cardoza5345/New-Member-Rocket-Engine/README.md

# New-Member-Rocket-Engine
Development of an engine prototype to be used in the production of a new member's rocket for incoming Rocket Project SDSU members to get hands-on experience in liquid fuel rocket production and introduce them to the club
