cardoza5345/New-Member-Rocket-Engine/NMR Tank Calcs.xlsx

Sheet: 6061-T6 Tank Specs
Store Bought T6-6061 Alumimum Tube
This Portion calculates the Factor of Saftey for a commercially available Aluminum tube as the basis for the TEZ fuel tanks
Outer Diameter (d_o) [in] | Thickness (t) [in] | Yield Strength (Sigma_y) [psi] | Allowable Stress (S) [psi] (ASME) | Radius (r) [in] | Mean Radius (r_m) [in] | Internal Operating Pressure (P) [psi]
4 | 0.1875 | 40000 | 26666.66667 | 2 | 1.953125 | 360
Hoop Stress (Sigma_h) [psi] | Axial Stress (Tau_a) [psi] | Burst Pressure | Burst Hoop Stress (Sigma_h) [psi] | Burst Axial Stress (Tau_a) [psi] | Desired Bulkhead FOS | Bulkhead stress [psi]
3750 | 1875 | 2500 | 26041.66667 | 13020.83333 | 4 | 10000
At MEOP --> | FOS (ASME) | FOS (ASME) (Corrected) | At burst pressure (2.78x MEOP) --> | FOS (ASME) | FOS (ASME Corrected) | Min. Bulkhead Thickness [in] | Note: Old ASME specifications typically defunct, use Corrected values
 | 7.111111111 | 10.66666667 |  | 1.024 | 1.536 | 0.3091187189
Links
Tube | here (https://www.onlinemetals.com/en/buy/aluminum/8-od-x-0-125-wall-x-7-75-id-aluminum-round-tube-6061-t6-extruded/pid/7083)
Material Sheet: | here (https://asm.matweb.com/search/specificmaterial.asp?bassnum=ma6061t6)
MMPDS Sheet: | here (https://drive.google.com/file/d/10JeMpgRRerTJnKGLHD3Lh879pCKpbLCK/view?usp=sharing)
 |  |  |  | Bore Diameter (d9) [in] |  | 3.762473228

Sheet: O-Ring (2-340) Parameters
 | O-ring OD [in] | O-ring ID (d1) [in] | Backup O-ring Area | O-ring Width [in] | O-ring Area [in^2] | Number of Backup Rings
 | 3.77 | 3.35 | 0.01281 | 0.2098425197 | 0.03458413089 | 0
Calculating parameters --> | Groove Diameter [in] | Chamber Width (to tank wall) [in] | Gland Width (b) [in] | Gland Area [in^2] | Squeeze (%) | Stretch (%) | Gland Fill (%)
 | 3.45 | 0.1570866142 | 0.2834645669 | 0.04452848906 | 25.14071295 | 2.985074627 | 77.6674251
From Paker handbook: | Dash Number | ID (d1) | O-ring Width (d2) | Groove Width (0 BURs) (b1) | Bore Diameter (d4/d9) |  | Groove Diameter (d3)
(metric) --> | 2-340 | 85.09 | 5.33 | 7.2 | 95.61 |  | 87.63
(imperial) --> |  | 3.35 | 0.2098425197 | 0.2834645669 | 3.764173228 |  | 3.45
 | Tolerances: (in) |  | MAX (+) | 0.0098 | 0.0025 | -0.0017 | 0.0000
 |  |  | MIN (-) | 0.0000 | 0.0000 | -0.0033 | -0.0039
 | Tolerances found here (https://theoreticalmachinist.com/IsoMetricTolerance) |  |  | ISO tolerances: | H8 | f7 | h9
 | (direct from handbook) -->
 | Links: | 431 O-rings | McMaster-Carr #9452K418 link (https://www.mcmaster.com/9452K209/?s=340+o+ring)
Spacing Notes | Space between o-rings should be 1-1.5x the diameter of the o-rings and no less than 1 mm
 | Lip width (distance from end of bulkhead to first o-ring) should be equal or greater than the groove width

Sheet: O-Ring (2-236) Parameters
 | O-ring OD [in] | O-ring ID (d1) [in] | Backup O-ring Area | O-ring Width [in] | O-ring Area [in^2] | Number of Backup Rings
 | 3.512 | 3.233858268 | 0.005831 | 0.138976378 | 0.0151695207 | 1
Calculating parameters --> | Groove Diameter [in] | Chamber Width (to tank wall) [in] | Gland Width (b) [in] | Gland Area [in^2] | Squeeze (%) | Stretch (%) | Gland Fill (%)
 | 3.330708661 | 0.1025590551 | 0.2519685039 | 0.02584165168 | 26.20396601 | 2.994886779 | 81.26617043 | <<
From Paker handbook: | Dash Number | ID (d1) | O-ring Width (d2) | Groove Width (0 BURs) (b1) | Bore Diameter (d4/d9) |  | Groove Diameter (d3)
(metric) --> | 2-236 | 82.14 | 3.53 | 6.4 | 89.81 |  | 84.6
(imperial) --> |  | 3.233858268 | 0.138976378 | 0.2519685039 | 3.535826772 |  | 3.330708661
 | Tolerances: (in) |  | MAX (+) | 0.0098 | 0.0025 | -0.0017 | 0.0000
 |  |  | MIN (-) | 0.0000 | 0.0000 | -0.0033 | -0.0039
 | Tolerances found here (https://theoreticalmachinist.com/IsoMetricTolerance) |  |  | ISO tolerances: | H8 | f7 | h9
 | (direct from handbook) -->
 | Links: | 431 O-rings | McMaster-Carr #9452K418 link (https://www.mcmaster.com/9452K165/?s=236+o+ring)
Spacing Notes | Space between o-rings should be 1-1.5x the diameter of the o-rings and no less than 1 mm
 | Lip width (distance from end of bulkhead to first o-ring) should be equal or greater than the groove width

Sheet: Bolt Circle Calculations
 | Bulkhead Mounting Screw Calculations
 | Inner casing diameter [in] | Thickness [in] | Operating pressure [psi] | Number of bolts | Bearing Yield Strength [psi] | Shear Strength [psi] | Ultimate Tensile Strength [psi] | Yield Tensile Strength [psi]
 | 3.625 | 0.1875 | 360 | 8 | 56000 | 30000 | 45000 | 40000
 | Bolt Force | Tear-out FOS | Tear-out Stress [psi] | Distance from end to bolt edge (Emin) [in] | Bolt TPI (UNF)
 | 464.4280233 | 4 | 7500 | 0.1651299639 | 16
 | Bearing FOS | Bearing Stress [psi] | Major bolt diameter [in] | Minor bolt diameter [in] | Tensile stress [psi] | Tensile FOS | Bolt shear stress [psi] | Bolt shear FOS
 | 4 | 14000 | 0.1769249613 | 0.09567496127 | 1876.135338 | 21.32042353 | 64599.91483 | 0.5224465093
Governing Force --> | Bolt shear FOS | Bolt shear stress [psi] | Major bolt diameter [in] | Minor bolt diameter [in] | Bearing Stress [psi] | Bearing FOS | Tensile stress [psi] | Tensile FOS
 | 4 | 8437.5 | 0.3459825695 | 0.2647325695 | 7159.174122 | 7.822131303 | 2151.656294 | 18.59032974
 | Tensile FOS | Tensile stress [psi] | Major bolt diameter [in] | Minor bolt diameter [in] | Bolt shear stress [psi] | Bolt shear FOS | Bearing Stress [psi] | Bearing FOS
 | 6.5 | 6153.846154 | 1.094660962 | 1.013410962 | 575.7810138 | 58.6160349 | 2262.754902 | 24.74859294
 | Major bolt diameter [in] | Minor bolt diameter [in] | Tensile stress [psi] | Tensile FOS | Bolt shear stress [psi] | Bolt shear FOS | Bearing Stress [psi] | Bearing FOS
 | 0.375 | 0.29375 | 2207.294746 | 18.12173027 | 6852.874604 | 4.924940547 | 6605.198554 | 8.478170571
 | Button Head Hex-Drive Screws: 1/2"-20 size | 1" length |  |  | P-List (McMaster)
 | Stainless Steel Button Head Hex-Drive Screws |  |  | link (https://www.mcmaster.com/92949A619/)
