cardoza5345/New-Member-Rocket-Engine/RCS_Nozzle.SLDPRT

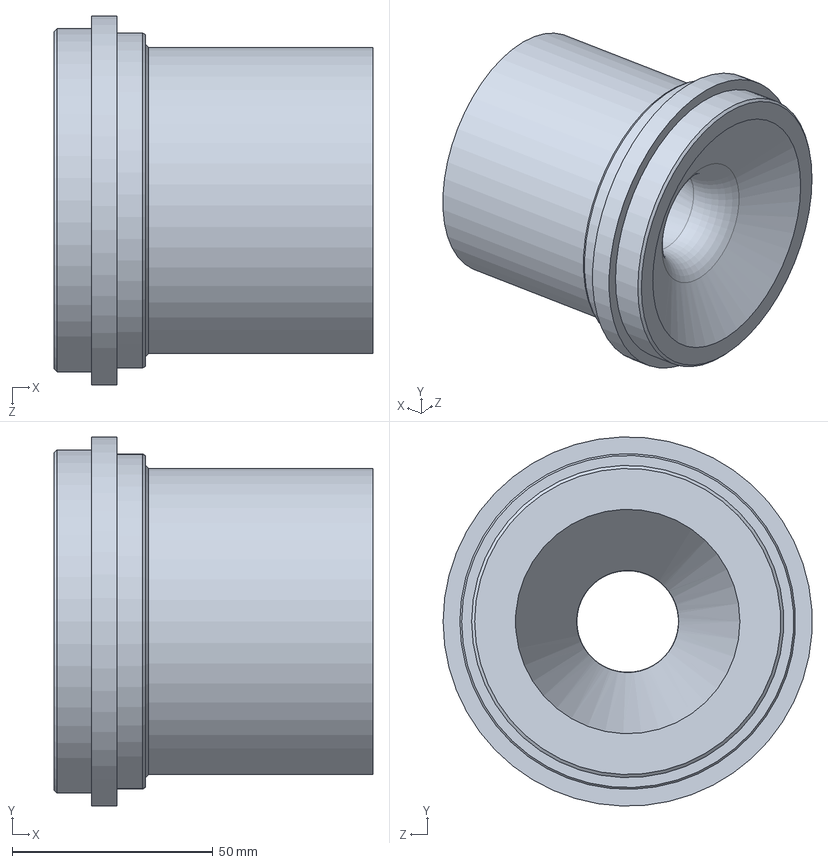
[picture p1: CAD file, 2026-09-25]
RCS_Nozzle.SLDPRT
79.4 x 91.9 x 91.8 mm
