cardoza5345/New-Member-Rocket-Engine/NMR_Chamber.SLDPRT

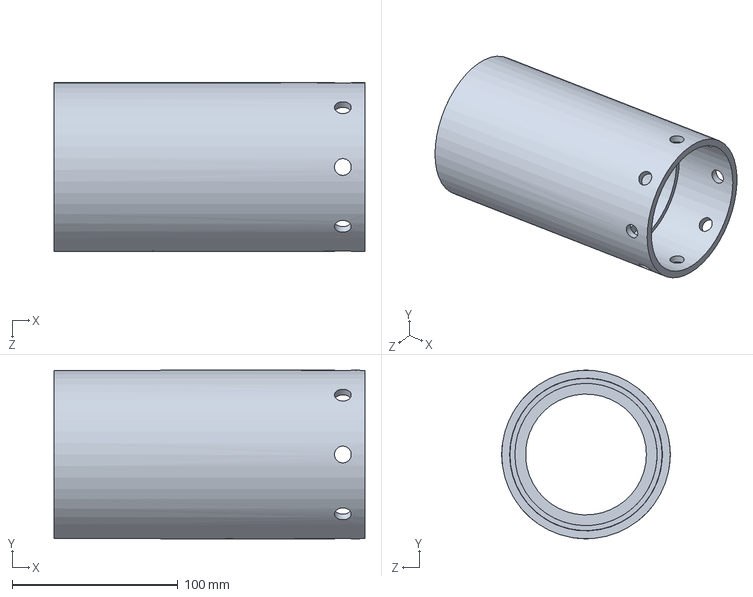
[picture p2: CAD file, 2026-09-25]
NMR_Chamber.SLDPRT
187.5 x 101.6 x 101.6 mm
