cardoza5345/New-Member-Rocket-Engine/NMR_Injector.SLDPRT

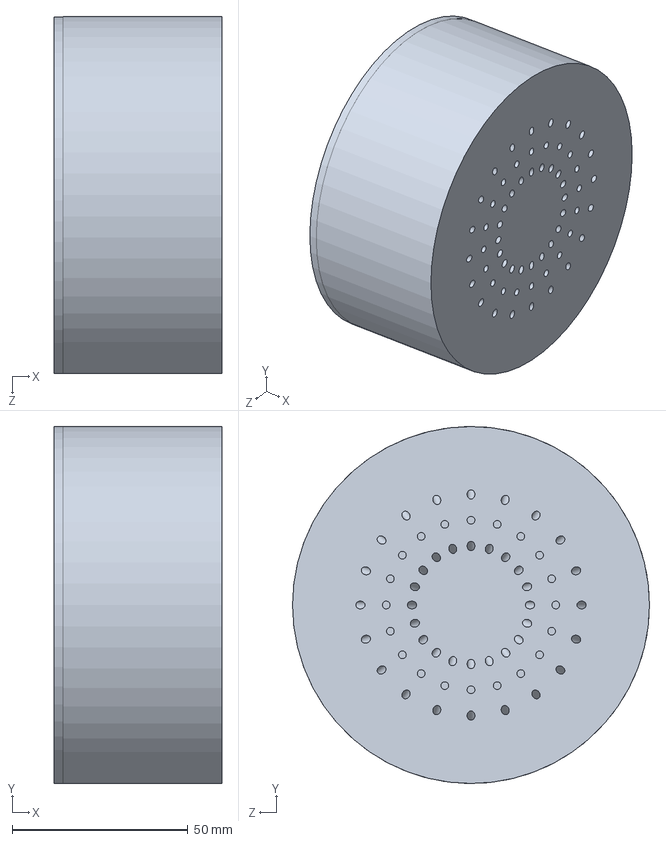
[picture p3: CAD file, 2026-09-25]
NMR_Injector.SLDPRT
47.8 x 101.6 x 101.6 mm
