cardoza5345/New-Member-Rocket-Engine/Engine_Mount2.SLDPRT

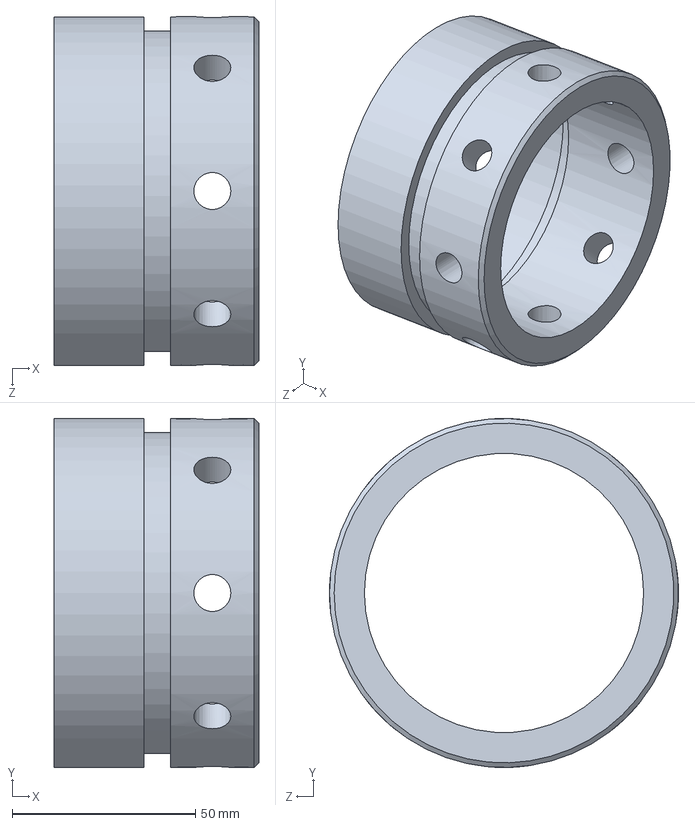
[picture p4: CAD file, 2026-09-25]
Engine_Mount2.SLDPRT
55.9 x 95.2 x 95.2 mm
