cardoza5345/New-Member-Rocket-Engine/Assem1.SLDASM

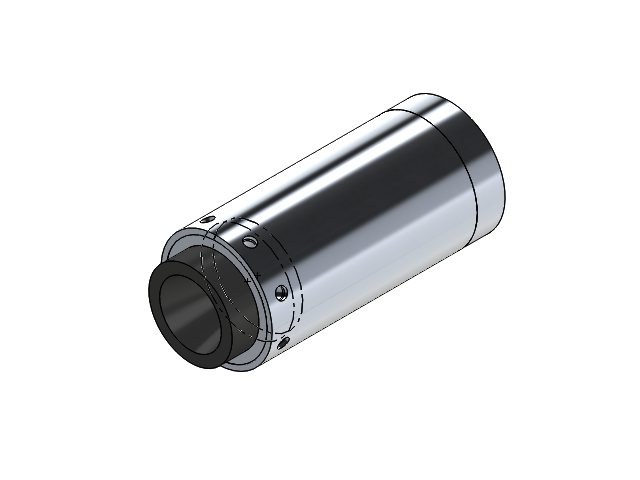
[picture p5: CAD file, 2026-09-25]
Assem1.SLDASM
9452K165_Oil-Resistant Buna-N O-Ring
9452K209_Oil-Resistant Buna-N O-Ring
9560K341_Ultra-Chemical-Resistant PTFE Backup Rings
Engine_Mount2
NMR_Chamber
NMR_Injector
RCS_Nozzle
