cardoza5345/New-Member-Rocket-Engine/NMR_EngineTesting_shortChamber.pdf

## Case name: NewNMRConfiguration

Description: New Members' Rocket prototype by Anthony Cardoza

Thu Sep 24 21:25:24 2026

Table 1. Propellant Specification
Component | Temperature, F Pressure, psi Enthalpy, Btu/lb-mol Enthalpy, Btu/lbm Mass fraction
RP-1 | 77.0 | 14.6959 | -10626.6881 | -760.343 | 0.2915452
O2(L) | -297.4 | 14.6959 | -5579.9487 | -174.380 | 0.7084548
Total | | | -8028.2104 | -345.215
Propellant exploded formula:
C0.485118 H0.945979 O1.029765 | (based on 1 mole)
C19.713319 H38.440973 O41.845708 | (by mass %)
α: | 0.7135152 (oxidizer excess coefficient)
O/F: | 2.4300000
O/F0: | 3.4056740 (stoichiometric)
rho: | 60.82582 lbm/ft

3

Table 2. Combustion Properties
Parameter | Injector Nozzle inlet Nozzle throat Nozzle exit Unit
Pressure | 360.0000 | 357.8509 | 207.3993 | 13.5809 psi
Temperature | 6284.5821 | 6282.1024 | 5971.0689 | 4496.1986 R
Enthalpy | -7792.5966 | -7830.3825 | -14620.3756 -44404.3224 Btu/lb-mol
-345.2155 | -346.8749 | -638.7720 | -1844.7997 Btu/lbm
Entropy | 0.0636 | 0.0636 | 0.0645 | 0.0678 Btu/(lb-mol·R)
2.8174 | 2.8176 | 2.8176 | 2.8176 Btu/(lbm·R)
Internal energy | -20273.0069 -20305.8683 | -26478.1872 -53333.2221 Btu/lb-mol
-898.1032 | -899.5214 | -1156.8461 | -2215.7553 Btu/lbm
Specific heat (p=const) | 1.5960 | 1.5964 | 1.5047 | 0.7099 Btu/(lbm·R)
Specific heat (V=const) | 1.3529 | 1.3532 | 1.2860 | 0.6084 Btu/(lbm·R)
Gamma | 1.1798 | 1.1797 | 1.1701 | 1.1669
Isentropic exponent | 1.1357 | 1.1356 | 1.1333 | 1.1616
Gas constant | 0.0880 | 0.0880 | 0.0868 | 0.0825 Btu/(lbm·R)
Molecular weight | 22.5731 | 22.5741 | 22.8883 | 24.0700
Density | 0.1205 | 0.1198 | 0.0741 | 0.0068 lbm/ft³
Sonic velocity | 3964.9401 | 3964.0126 | 3833.9890 | 3284.5709 ft/s
Mach number | 0.0000 | 0.0727 | 1.0000 | 2.6382
Area ratio | 8.2200 | 8.2200 | 1.0000 | 4.8400 A/At
Mass flux | 34.5405 | 34.5405 | 284.0239 | 58.7065 lbm/ft²·s
Viscosity | 0.7225 | 0.7223 | 0.6978 | 0.5740 x10⁻⁴ lbm/(ft·s)
Conductivity, frozen | 0.3631 | 0.3629 | 0.3461 | 0.2661 Btu/(hr·ft·R)
Specific heat (p=const), frozen | 0.4913 | 0.4913 | 0.4891 | 0.4739 Btu/(lbm·R)
Prandtl number, frozen | 0.6336 | 0.6336 | 0.6390 | 0.6623
Conductivity, effective | 1.6064 | 1.6064 | 1.4570 | 0.5452 Btu/(hr·ft·R)
Specific heat (p=const), effective | 1.5960 | 1.5964 | 1.5047 | 0.7099 Btu/(lbm·R)
Prandtl number, effective | 0.4652 | 0.4652 | 0.4670 | 0.4843

Table 3. Combustion Products

Product | Injector mass fraction Injector mole fraction Nozzle inlet mass fraction Nozzle inlet mole fraction Nozzle throat mass fraction Nozzle throat mole fraction Nozzle exit mass fraction Nozzle exit mole fraction
CO | 0.4274796 0.3445030 0.4274337 0.3444804 0.4167612 0.3405537 0.3735296 0.3209864
CO2 | 0.2463378 0.1263505 0.2464102 0.1263929 0.2632003 0.1368840 0.3311533 0.1811169
COOH | 0.0000173 0.0000087 0.0000172 0.0000086 0.0000101 0.0000051 0.0000004 0.0000002
H | 0.0016631 0.0372466 0.0016628 0.0372410 0.0014162 0.0321581 0.0003537 0.0084465
H2 | 0.0091419 0.1023681 0.0091414 0.1023669 0.0089170 0.1012436 0.0089863 0.1072986
H2O | 0.2476966 0.3103640 0.2477211 0.3104077 0.2559646 0.3252010 0.2804239 0.3746712
H2O2 | 0.0000087 0.0000058 0.0000087 0.0000057 0.0000049 0.0000033
HCHO,form aldehy | 0.0000005 0.0000004 0.0000005 0.0000004 0.0000003 0.0000002
HCO | 0.0000202 0.0000157 0.0000201 0.0000156 0.0000113 0.0000089 0.0000004 0.0000004
HCOOH | 0.0000021 0.0000010 0.0000021 0.0000010 0.0000012 0.0000006
HO2 | 0.0000657 0.0000449 0.0000655 0.0000448 0.0000376 0.0000261 0.0000004 0.0000003
O | 0.0077444 0.0109263 0.0077380 0.0109178 0.0055932 0.0080014 0.0002088 0.0003141
O2 | 0.0180667 0.0127449 0.0180558 0.0127377 0.0139483 0.0099770 0.0005981 0.0004499
OH | 0.0417553 0.0554201 0.0417229 0.0553795 0.0341339 0.0459370 0.0047449 0.0067153
Gaseous fraction: | 1.0000000 1.0000000 1.0000000 1.0000000 1.0000000 1.0000000 1.0000000 1.0000000
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
1.7828 | 10.3402 | 8452.7428 | 262.7193 | 1.4817 | 417.7032
1.8208 | 10.2603 | 8458.8817 | 262.9101 | 1.4828 | 418.0066
1.8591 | 10.1804 | 8465.0274 | 263.1011 | 1.4839 | 418.3103
1.8978 | 10.1000 | 8471.2099 | 263.2933 | 1.4850 | 418.6158

Table 7. Throttled Performance (delivered)

Throttle
value

Mass
flow
rate,
lbm/s

Pressur
e, psi

Specific
impulse,
lbf·s/
lbm Sea
level

Specific
impulse,
s Sea
level

Thrust,
lbf Sea
level

Specific
impulse,
lbf·s/
lbm
Optimu
m
expansi
on

Specific
impulse,
s
Optimu
m
expansi
on

Thrust,
lbf
Optimu
m
expansi
on

Specific
impulse,
lbf·s/
lbm
Vacuum

Specific
impulse,
s
Vacuum

Thrust,
lbf
Vacuum
1.0000 | 1.5899 360.000
| 0

252.3093 252.3093 401.152
2

254.9742 254.9742 405.3891 287.4314 287.4314 456.9936

Table 8. Chamber Size

Combustion chamber size

Dc | 2.87 in
Dt | 1.00 in
Lcyl | 3.52 in
Lc | 4.35 in
L* | 31.41 in
R1 | 0.50 in
R2 | 0.00 in
b | 60.00 deg
Ac/At | 8.22

Nozzle size

Type | Conical nozzle
Rn | 0.50 in
Tn | 15.00 deg
Te | 15.00 deg
De | 2.20 in
Le | 2.31 in
Le/Dt | 2.31
Le/Lc15 | %
Ae/At | 4.84
Parameter | | Engine | Chamber
Thrust | sea level | 401.1522 | 401.1522 lbf
| opt exp | 405.3891 | 405.3891 lbf
| vacuum | 456.9936 | 456.9936 lbf
Specific Impulse | sea level | 252.3093 | 252.3093 lbf·s/lbm
| opt exp | 254.9742 | 254.9742 lbf·s/lbm
| vacuun | 287.4314 | 287.4314 lbf·s/lbm
Mass flow rate | total | 0.7212 | 0.7212 lbm/s
| oxidizer | 0.5109 | 0.5109 lbm/s
| fuel | 0.2103 | 0.2103 lbm/s
| film coolant | n.a. | n.a. lbm/s
Number of chambers | | 1

Table 10. Thermal Analysis
