cardoza5345/New-Member-Rocket-Engine/CEA Test 1/cea_test1_2.png

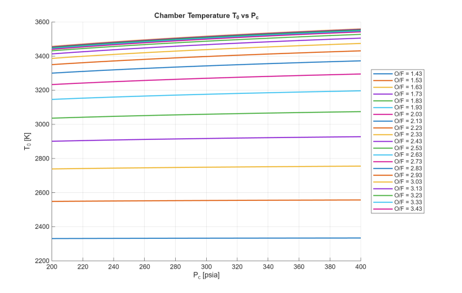
CEA Test 1/cea_test1_2.png
