cardoza5345/New-Member-Rocket-Engine/CEA Test 1/cea_test1_3.png

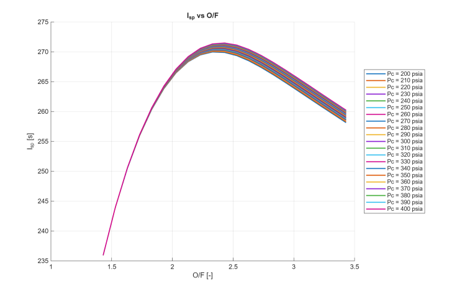
CEA Test 1/cea_test1_3.png
