cardoza5345/New-Member-Rocket-Engine/CEA Test 2/cea1.png

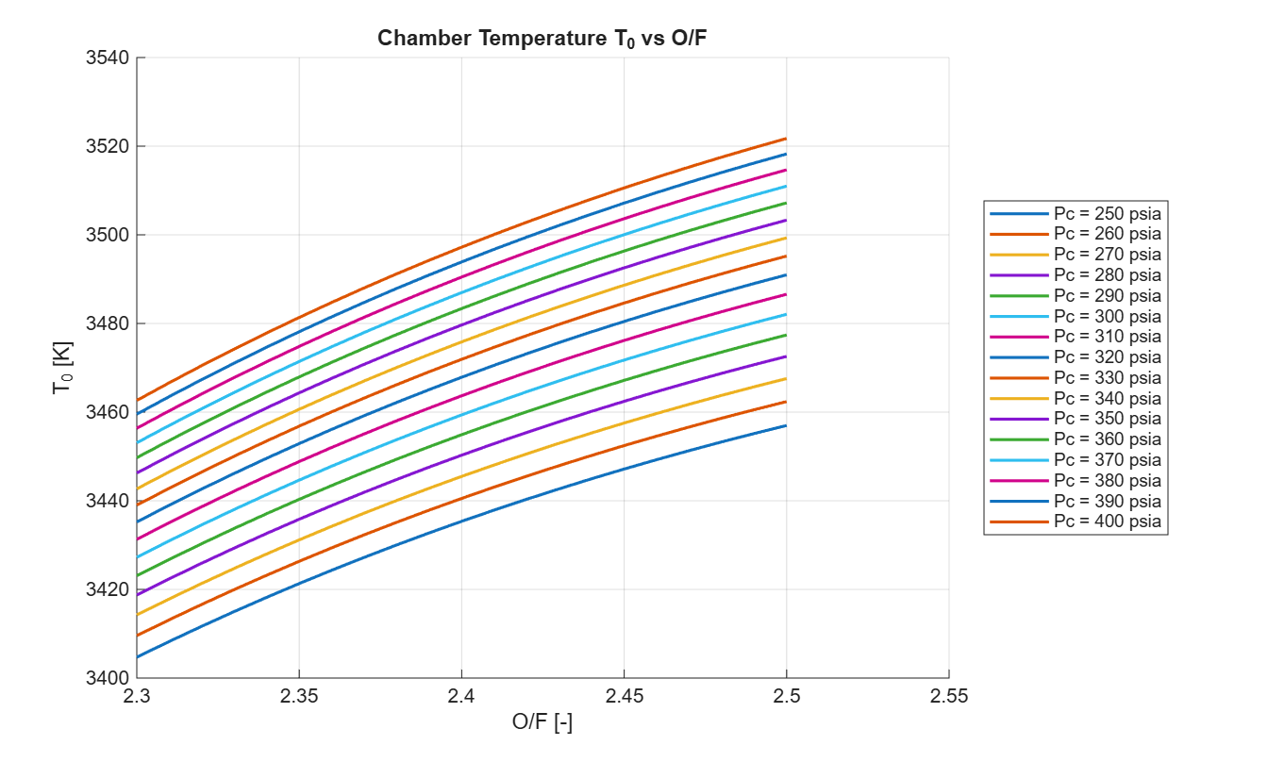
CEA Test 2/cea1.png
