cardoza5345/New-Member-Rocket-Engine/CEA Test 2/cea3.png

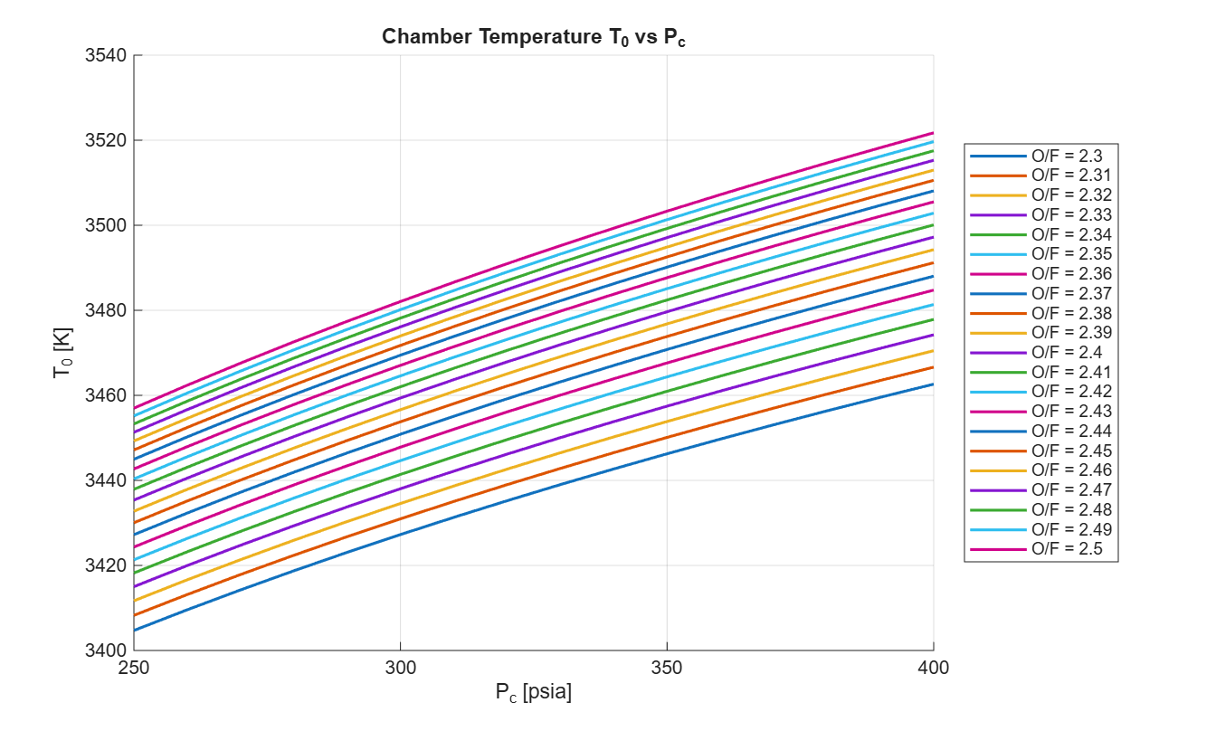
CEA Test 2/cea3.png
